shree-surya/Contactor_IQC_Esp/hmi/README.md

# Contactor IQC – HMI firmware (CrowPanel 7")

Touch-screen firmware for the **Elecrow CrowPanel 7" ESP32-S3 (DIS08070H, V3.0)**.

This first build has the **complete UI with a simulated test rig**. You can log in, pick a
model, enter 5 serials and run a full 5-channel batch on the screen before any relay,
INA219 or sub-board is wired. The header shows `SIM` while the simulation is active.

| Step | Status |
|---|---|
| UI: all screens, keyboard, 5-channel test table | ✅ this build |
| Test sequence (staggered start, stop at first fail, -NA- logging) | ✅ runs against simulated hardware |
| WiFi: up to 5 saved networks (WIFI page), retried every 15 s | ✅ this build |
| Google Sheets (specs, operators, results upload, offline queue) | ✅ needs `include/secrets.h` |
| I²C link to the ESP32-S3 sub-board | ⏳ after the parts arrive |

## Screens

| | |
|---|---|
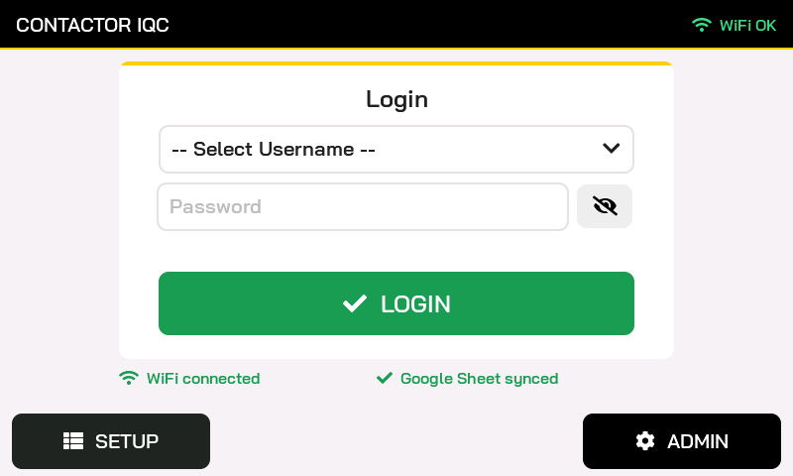
[picture p1: hmi/docs/screenshots/1_login.png]
Login
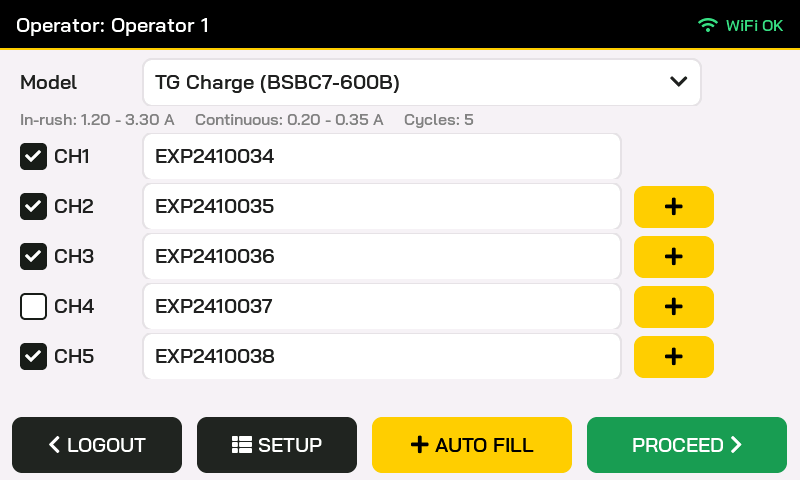
[picture p2: hmi/docs/screenshots/2_model_serials.png]
Model & serials
|  |  |
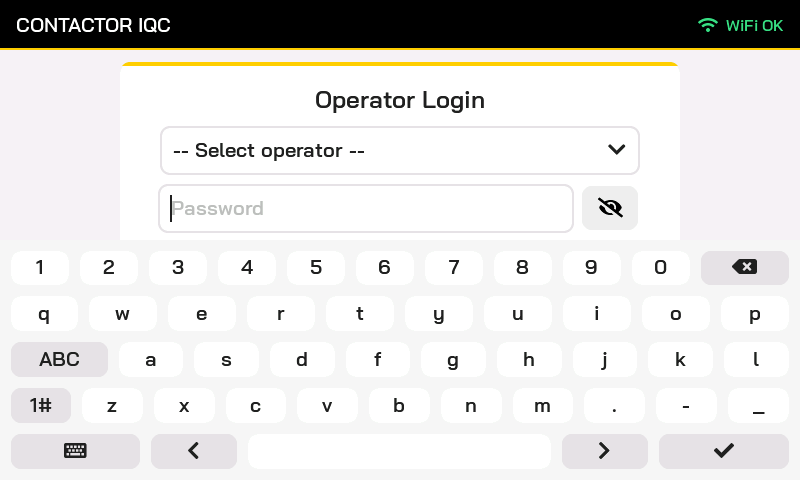
[picture p3: hmi/docs/screenshots/3_keyboard.png]
Keyboard
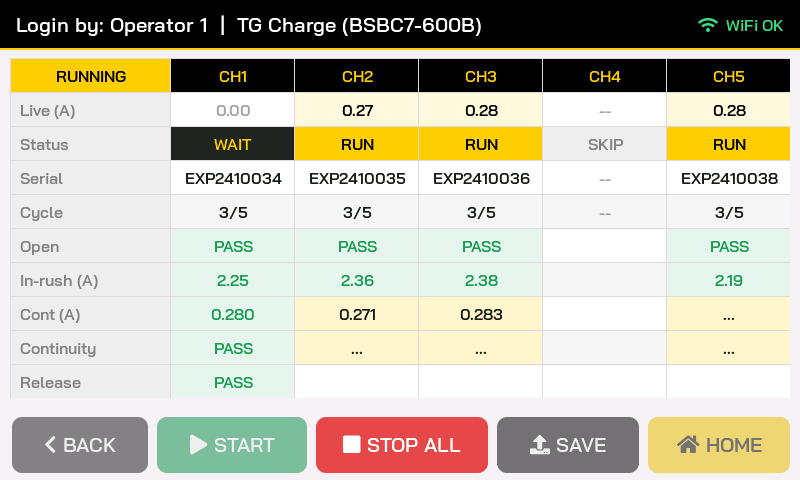
[picture p4: hmi/docs/screenshots/4_test_running.png]
Test running
|  |  |
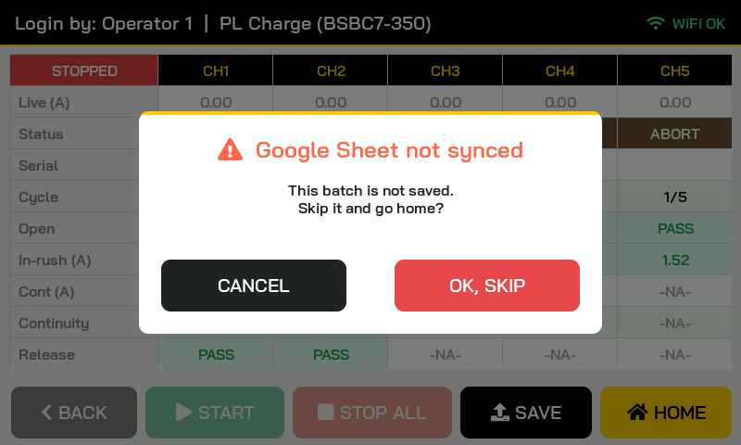
[picture p5: hmi/docs/screenshots/5_test_done_with_fail.png]
HOME without saving
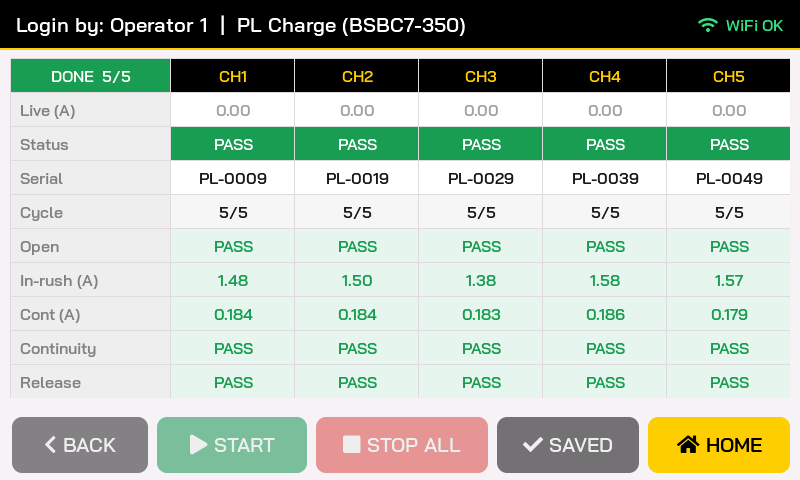
[picture p6: hmi/docs/screenshots/6_saved.png]
Saved
|  |  |
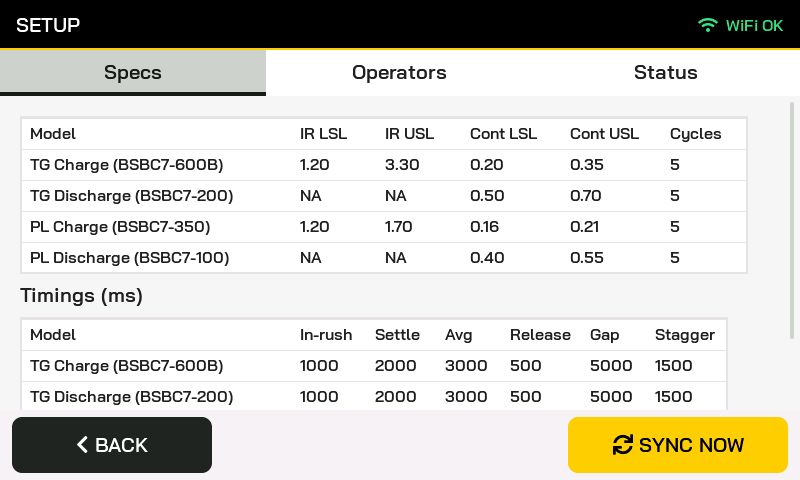
[picture p7: hmi/docs/screenshots/7_setup.png]
Setup
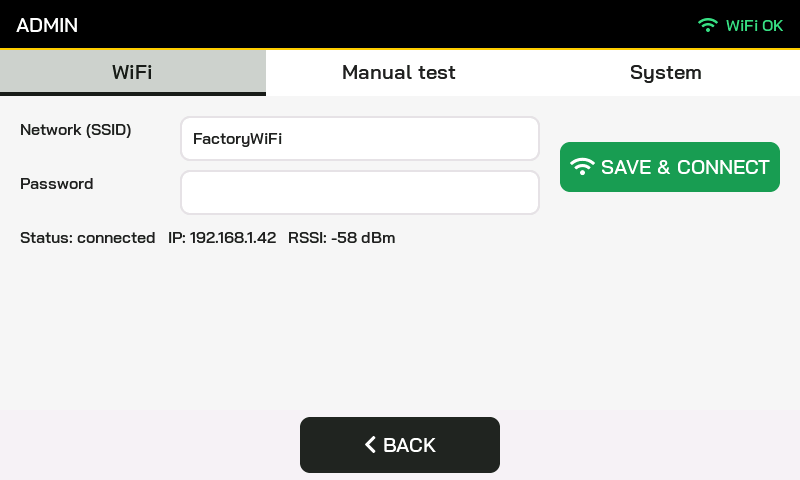
[picture p8: hmi/docs/screenshots/8_admin_wifi.png]
Admin
|  |  |

## Flashing (first time)

1. In VS Code: **File → Open Folder…** and select `hmi` (the folder that contains
   `platformio.ini`, not the repository root).
2. Wait for PlatformIO to finish "Installing…" in the bottom bar. The first time it downloads
   the ESP32 toolchain, LVGL and LovyanGFX, which takes 5–10 minutes.
3. Connect the CrowPanel to the PC with the USB-C port marked **UART0**.
4. Click **✓ Build** (bottom bar), then **→ Upload**.
   - If the upload can't find the board, uncomment `upload_port = COM11` in `platformio.ini`.
   - If it still fails, hold **BOOT**, tap **RESET**, release **BOOT**, then upload again.
     Press **RESET** after the upload finishes.
5. Click the **plug icon (Serial Monitor)** to see the log at 115200 baud. You should see
   `Contactor IQC HMI 0.1.0-ui-sim`.

## Trying it out

1. **Login:** pick *Operator 1* → LOGIN.
2. **Model:** pick a model and type a serial for CH1 with the on-screen keyboard.
   - **+** next to CH2…CH5 copies the serial above and adds 1 (`EXP2410034` → `EXP2410035`).
   - **AUTO FILL** fills every empty channel that way.
   - **COPY / PASTE / CLEAR** are on the keyboard.
   - Untick a channel to skip it.
3. **PROCEED → START.** Channels start 1.5 s apart, each runs 5 cycles, and about 2% of
   simulated cycles get a random fault, so you will see the occasional FAIL.
4. **STOP ALL** switches everything off and marks the unfinished steps `-NA-`.
5. **SAVE** (enabled when every channel has finished, or after STOP ALL) sends the batch to the
   Google Sheet. Results stay in RAM until then; nothing is uploaded during a test.
6. **HOME** goes back to the model page for the next batch. If the batch was not saved it asks
   first ("Google Sheet not synced"): **OK, SKIP** throws the results away, **CANCEL** stays on the page.
7. While a channel rests between cycles its Status shows **WAIT**, and **RUN** again when the next cycle starts.
8. **Retest:** a finished channel (PASS / FAIL / ABORT) shows ↻ on its CH header. Tap it to run that
   channel again from cycle 1; the others keep going. Only the newest result is saved. Not after SAVE.
9. **WIFI** (login screen, password `100100`): scan, connect to a network with its password, or FORGET a
   saved one. Up to 5 are saved; while WiFi is down the panel tries them every 15 s, forever.
10. **PENDING** (login screen): results saved on the panel but not in the Google Sheet yet. The badge
   shows how many; rows disappear as they upload. **UPLOAD NOW** tries straight away.
11. **ADMIN** (password `100100`): toggle relays manually, view system info.

Saved rows are uploaded straight from RAM; only if that fails are they kept in flash and retried automatically; Setup → Status shows the Sheets state. While the rig is simulated (`SIM` in the header), the uploaded rows are simulated data too.

## If something looks wrong

| Symptom | What to tell me / try |
|---|---|
| Screen stays black | Send the Serial Monitor log. The backlight pin may differ on your board revision. |
| Display works but touch doesn't | Send the log line that starts with `[display]`. |
| Touch is offset or mirrored | Tell me which corner you tap and where the press lands. |
| Picture shifts or flickers when WiFi connects | Known ESP32-S3 RGB-panel issue; I'll lower the pixel clock in `display.cpp`. |

## Code layout

```
hmi
├── platformio.ini        board, PSRAM, libraries (LVGL 8.3.11, LovyanGFX 1.1.16)
├── include/lv_conf.h     LVGL settings
└── src
    ├── main.cpp          setup()/loop()
    ├── config.h          constants: channels, password, current range, I2C pins
    ├── display.cpp       RGB panel + GT911 touch + LVGL driver
    ├── app_data.cpp      models/limits and operator list (built-in defaults for now)
    ├── rig.cpp           5-channel test sequencer (moves to the sub-board later)
    ├── hw_sim.cpp        simulated relays / INA219 / contacts
    ├── net.cpp           WiFi
    ├── gsheets.cpp       Google Sheets: login (JWT), read Specs/Operators, append Results, flash queue
    ├── google_roots.h    Google root certificates for HTTPS
    ├── serial_util.cpp   "+" serial increment
    ├── fonts/            Bai Jamjuree SemiBold 16/20/24/32 px (+ LVGL symbols), OFL licence
    └── ui/
        ├── ui_theme.h    all colours, fonts and sizes
        ├── ui_common.cpp header, footer, buttons, pop-ups
        ├── ui_login.cpp  operator login
        ├── ui_model.cpp  model + 5 serials + keyboard
        ├── ui_test.cpp   5-channel result table
        ├── ui_setup.cpp  specs / operators / status (view only)
        ├── ui_wifi.cpp   WiFi networks: scan, connect, forget
        ├── ui_pending.cpp results not in the Google Sheet yet
        └── ui_admin.cpp  password, manual relay test, system
```

To change colours or text sizes, edit `src/ui/ui_theme.h`. Light theme: black bars with yellow
`#FFCC00` accents, white/light-grey surfaces, grey text `#808080` / `#A0A0A0`, green for PASS,
red for FAIL. Font: Bai Jamjuree SemiBold.

Fonts were generated with `lv_font_conv` (4 bpp, ASCII + LVGL symbols). To add a size, run e.g.:
`npx lv_font_conv --bpp 4 --size 28 --no-compress --font BaiJamjuree-SemiBold.ttf --range 0x20-0x7E --font FontAwesome5-Solid+Brands+Regular.woff --range <symbol list from font_bai_16.c header> --format lvgl --lv-include lvgl.h -o font_bai_28.c`
