shree-surya/Contactor_IQC_Esp/docs/GOOGLE_SHEETS_SETUP.md

# Google Sheets setup

The rig reads **Specs** and **Operators** from a Google Sheet and appends test results to its
**Results** tab. It signs in with a Google Cloud **service account** (JSON key), so no Apps
Script is needed.

Allow about 30 minutes. You only do this once.

---

## Part A: Create the Sheet from the template

1. Download [`Contactor_IQC_Sheet_Template.xlsx`](Contactor_IQC_Sheet_Template.xlsx) from this folder.
2. Open **drive.google.com**, then **New → File upload**, and pick the template.
3. Double-click the uploaded file. It opens in Google Sheets.
4. **File → Save as Google Sheets.** This step is required: the API can't write to an `.xlsx`.
   A new copy opens.
5. Rename that copy to **Contactor IQC** (top-left title) and delete the uploaded `.xlsx` from Drive.
6. Check it has 4 tabs: **Specs, Operators, Results, README**.
   - **Specs:** check the 4 models and their limits.
   - **Operators:** column A = name, column B = login password (max 10 rows; empty password = none).
   - Don't rename tabs or edit header rows.
7. Copy the **Sheet ID** from the address bar and keep it for Part D:

   ```
   https://docs.google.com/spreadsheets/d/1AbCdEfGhIjKlMnOpQrStUvWxYz0123456789/edit#gid=0
                                          └──────────── this is the Sheet ID ───────┘
   ```

---

## Part B: Create the service account (Google Cloud)

1. Open **console.cloud.google.com** and sign in with the same Google account.
2. Top bar → project picker → **New Project**. Name it `Contactor-IQC` → **Create**, then select it.
3. **☰ Menu → APIs & Services → Library**. Search **Google Sheets API** → open it → **Enable**.
4. **☰ Menu → IAM & Admin → Service Accounts → + Create service account**.
   - Name: `iqc-rig` → **Create and continue**.
   - Roles: leave empty → **Continue** → **Done**.
5. Click the new account (`iqc-rig@contactor-iqc-xxxx.iam.gserviceaccount.com`) → **Keys** tab →
   **Add key → Create new key → JSON → Create**. A `.json` file downloads.
   - If you see *"Service account key creation is disabled"*, your company blocks keys by policy.
     Ask IT to allow it for this project (policy `iam.disableServiceAccountKeyCreation`).
6. **Keep this JSON file private.** Don't email it, upload it to GitHub, or send it in chat. Anyone
   with it can edit the Sheet.

---

## Part C: Share the Sheet with the service account

1. Open the JSON file in Notepad and copy the `client_email` value
   (ends in `.iam.gserviceaccount.com`).
2. In the **Contactor IQC** Sheet: **Share** → paste that email → role **Editor** →
   untick *Notify people* → **Share**.

---

## Part D: Put the key into the firmware

1. In `hmi/include/`, copy `secrets.example.h` and name the copy **`secrets.h`**.
   `secrets.h` is listed in `.gitignore`, so it never goes to GitHub.
2. Fill it from the JSON file and the Sheet ID:

   | `secrets.h` | Where it comes from |
   |---|---|
   | `GSHEET_ID` | Part A step 7 |
   | `GSA_PROJECT_ID` | JSON `project_id` |
   | `GSA_CLIENT_EMAIL` | JSON `client_email` |
   | `GSA_PRIVATE_KEY` | JSON `private_key`: copy everything between the quotes, **including** the `\n` sequences, exactly as it is |

3. Save. Don't commit. Run `git status` and check that `secrets.h` is **not** listed.

---

## Part E: Network check

From a laptop on the **same WiFi** the rig will use, open these in a browser:

- `https://oauth2.googleapis.com`
- `https://sheets.googleapis.com`

Any response (even "404" or "Not Found") means the network allows it. "Blocked", a login page,
or a timeout means IT has to allow those two hosts.

---

## When you're done

Tell me **"Sheets setup done"**. Don't send the key or the JSON. I'll then add the Sheets code to
the firmware:

- download Specs + Operators at boot and on **SYNC NOW**, and cache them in flash for offline use
- append one Results row per channel per cycle
- queue rows in flash while WiFi is down and upload them later
- timestamp from Google's clock, `*` when the rig was offline

---

## Results layout (one row per contactor)

Each tested contactor is **one row**:

`S.No | Serial | Timestamp | Operator | Model | Channel | Overall | Fail Step | 1- Contin. OFF | 1- Inrush (A) | 1- Inrush P/F | 1- Cont (A) | 1- Cont P/F | 1- Contin. ON | 1- Release | 2- Contin. OFF | … | 5- Release`

- **Overall** is PASS (all cycles passed), FAIL, or ABORTED (STOP ALL).
- Up to 5 cycles per unit (the **Cycles** column in Specs can be 1 to 5).
- Cycles that were not run (after a failure, or a model with fewer than 5 cycles) show `-NA-` or stay empty.
- **Contin. OFF** is the main-terminal state before the coil is switched on: `OPEN` = pass, `CLOSE` = FAIL
  (welded or stuck). `OPEN` with Fail Step "Contin OFF: current" means coil current flowed with the relay off.
- **Contin. ON** is the main-terminal state while the coil is on: `CLOSE` = pass, `OPEN` = FAIL.
- The **Timestamp** is when the unit finished (IST), written as text. A `*` at the end means the rig was
  offline when the unit finished, and the time shown is when the row was uploaded.

### Updating a Sheet you already made

If your **Results** header still says `1- Open` / `1- Continuity`, rename them to `1- Contin. OFF` /
`1- Contin. ON` (same for cycles 2 to 5), or paste the header from `docs/results_header.tsv`.

If your **Results** tab still has an older header (one row per cycle, or columns up to `10- Release`):

1. Delete all rows in **Results**, including the header.
2. Open [`results_header.tsv`](results_header.tsv), select all, copy.
3. Click cell **A1** of **Results**, then paste. The 43 headers fill row 1 (A to AQ). Delete any columns to the right of AQ.
4. (Optional) Make row 1 bold and use **View → Freeze → 1 row**.

Also check **Operators** has the password in column B.
