shree-surya/Contactor_IQC_Esp/(commit log)

2026-10-07 Add CrowPanel 7" HMI firmware with simulated 5-channel rig
    Touch UI (LVGL 8.3 + LovyanGFX) for the CrowPanel DIS08070H V3.0:
    operator login, model + 5 serials with increment/copy/paste, 5-channel
    result table, setup view, admin (WiFi, manual relay test, system).
    Includes the 5-channel test sequencer running on simulated hardware
    until the ESP32-S3 sub-board is built.
    Claude-Session: https://claude.ai/code/session_01LXTvxhwrQucbbkRLzNXi3e
2026-10-07 Fix build: use I2C port number instead of I2C_NUM_1
    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
    [display.cpp]
2026-10-07 Dark theme with Bai Jamjuree, live current row, Google Sheets template
    - Near-black base with cyan/orange/lime accents (red reserved for FAIL)
    - Bai Jamjuree SemiBold fonts (16/20/24/32 px) with LVGL symbols merged
    - Test screen: per-channel live current row, batch state in the table
    corner; removed round/live line and bottom event line
    - docs/: Google Sheet template (Specs, Operators, Results, README) and
    step-by-step service-account setup guide
    - hmi/include/secrets.example.h for the service-account key
    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
    [Contactor_IQC_Sheet_Template.xlsx]
2026-10-07 Light theme, Live row on top, Google Sheets link with offline queue
    - Light theme from the reference design: black bars, #FFCC00 accent,
    grey secondary text, green PASS / red FAIL, Bai Jamjuree
    - Test table order: Live (A), Status, Serial, Cycle, then the steps
    - NEXT BATCH clears the model so it is chosen again for every batch
    - gsheets: service-account login (RS256 JWT via mbedTLS), reads Specs and
    Operators at boot / SYNC NOW, caches them in LittleFS, appends Results
    rows from a flash queue in a background task, clock from NTP with an
    HTTP Date fallback, rows logged offline get the upload time plus '*'
    - Setup > Status shows Sheets state, last sync, rows to upload, clock
    Co-Autho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
    [app_data.cpp, app_data.h, config.h, google_roots.h, gsheets.cpp, gsheets.h, main.cpp]
2026-10-07 Operator passwords from the Sheet, factory WiFi via secrets.h
    - Login screen: password field with keyboard; checked against column B of
    the Operators tab (last synced copy, so it also works offline);
    empty password in the Sheet = no password
    - Sheets sync reads Operators!A2:B11 and caches the passwords
    - secrets.h can define WIFI_SSID / WIFI_PASS, used until other
    credentials are saved on the Admin screen
    - Template and setup guide updated with the password column
    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
    [Contactor_IQC_Sheet_Template.xlsx]
2026-10-07 Login status and sync gate, eye icon, number-row keyboard, one Results row per unit
    - Login: WiFi and Google Sheet status line; operator selection unlocks
    once the Sheet has synced (or after 30 s offline with a saved copy)
    - Password field: show/hide eye button; text keyboards get a number row
    - Top bar: colour-coded WiFi indicator on every screen (green connected,
    blinking yellow connecting, grey none); upload count and SIM removed
    - NEXT BATCH: popup waits for the Sheet upload, shows success (or saved
    offline), then returns to the model / serial page
    - Results: one row per contactor - S.No, Serial, Timestamp, Operator,
    Model, Channel, Overall, Fail Step, then 7 columns per cycle (u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
    [Contactor_IQC_Sheet_Template.xlsx, results_header.tsv]
2026-10-07 Fix README screenshot links, version 0.3.0
    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
    [config.h]
2026-10-08 Fix test-screen flicker, pause Sheet uploads during tests, 5-cycle Results
    - Test grid uses one object per cell instead of lv_table, so a value change
    redraws only that cell (~40x less frame-buffer traffic while running)
    - Sheet uploads and syncs wait while a test runs; NEXT BATCH uploads them
    - MAX_CYCLES 5: Results template and header TSV now end at 5- Release (43 cols)
    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
    [Contactor_IQC_Sheet_Template.xlsx, results_header.tsv]
2026-10-09 SAVE button, HOME replaces NEXT BATCH, WAIT status between cycles, login wording
    - Finished units stay in RAM during a test; SAVE (enabled when all channels
    are done or after STOP ALL) queues and uploads them. Writing flash while
    the RGB panel draws caused the glitch seen after the first unit finished.
    - HOME goes to the model page; unsaved results need a DON'T SAVE confirmation
    - Channel status shows WAIT while resting between cycles
    - Login: 'Login', 'Select Username'; header 'Login by: name'
    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
    [config.h, gsheets.cpp, main.cpp, rig.cpp, rig.h]
2026-10-09 HOME interlock popup: 'Google Sheet not synced' with CANCEL / OK, SKIP
    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
    [config.h]
2026-10-09 Fix SAVE glitch: upload from RAM, flash only when offline; static save popup
    - SAVE no longer writes rows to flash; they are uploaded straight from RAM.
    Only if the upload can't happen (no WiFi, error, 20 s) are they persisted.
    Flash writes and the queue rewrite stalled the PSRAM bus feeding the panel.
    - Save popup has no spinner (constant frame-buffer redraws during TLS)
    - Each row's timestamp is taken when the unit finishes, not at SAVE
    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
    [config.h, gsheets.cpp, gsheets.h, rig.cpp, rig.h]
2026-10-09 Keep WiFi/TLS buffers in internal RAM; pixel clock in config.h
    The RGB panel reads its frame buffer from PSRAM continuously; uploads with
    their buffers in PSRAM compete for the same bus. Allocations up to 64 KB now
    prefer internal RAM (automatic fallback to PSRAM). PANEL_PCLK_HZ in config.h
    makes the display clock easy to lower if glitches remain.
    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
    [config.h, display.cpp, main.cpp]
2026-10-09 Power-cut safe flash files: cache written via temp file, interrupted swaps recovered at boot
    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
    [config.h, gsheets.cpp]
2026-10-15 rig: INA219 bring-up firmware for the ESP32-S3 sub-board
    Reads 5 INA219s (4 on I2C0 at 0x40/41/44/45, 1 on I2C1) and prints current
    and bus voltage; serial commands for bus scan and a 1 s fast peak test
    (shunt-only 9-bit, ~84 us per sample). Wiring guide in rig/README.md.
    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
2026-10-15 rig: all 5 INA219 on I2C0 (CH5 at 0x42 via A0=SDA), I2C1 reserved for the HMI link
    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
2026-10-23 rig: optional bench setup with CH5 on bus B (no address wire needed)
    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
2026-10-27 rig: 20 ms I2C timeout so a stuck bus doesn't freeze the scan for minutes
    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
2026-10-27 rig: single-file Arduino IDE version of the INA219 test
    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
2026-10-27 rig: use the USB Native port (UART port holds the 7Semi board in reset with a monitor open)
    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
2026-10-27 rig: single-sensor capture sketch (auto-detect, auto-trigger, in-rush + continuous report)
    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
2026-10-27 rig capture: hardware-averaged hold current (PWM economizer coils), supply voltage, ignore after power-off
    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
2026-10-27 rig: 5-sensor capture sketch (in-rush + averaged hold per channel, cross-channel deviation)
    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
2026-10-27 rig: relay board test sketch
    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
2026-10-28 Connect the HMI to the real rig board over I2C
    Rig board (rig/arduino/rig_firmware): samples 5 INA219s (peak + average since
    reset), drives 5 relays, I2C slave 0x30 on GPIO 17/18, relays off if the HMI
    goes silent for 1.5 s.
    HMI 0.4.0: hw.h interface with hw_link.cpp (real board, RIG_LINK 1, uses the
    touch controller's I2C port through LovyanGFX) and hw_sim.cpp (RIG_LINK 0).
    Sequencer uses the board's in-rush peak and window average (correct for PWM
    economizer coils); without contact inputs Open/Release use current only and
    Continuity is -NA-. START checks the rig board and every ticked sensor; a lost
    link stops the test.
    Claude-Sessi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
2026-10-28 capture5: all 5 sensors on GPIO 8/9, CH5 at 0x42, bus scan at start
    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
2026-10-28 rig: relay + 5-sensor bench sketch (toggle relays, live current/voltage, in-rush/hold per switch-on)
    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
2026-10-28 Rig link diagnostics: rig board prints relay changes and command/read counts; HMI shows relay command errors (0.4.1)
    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
2026-10-28 Continuity check for 4-pin contactors, chosen per model from the Specs sheet (0.5.0)
    - Specs tab: new column M "Continuity" (Yes / No). Yes = feedback contact
    is checked and the HMI shows CLOSE / OPEN; No (2-pin) shows -NA-.
    - Rig board firmware: reads feedback contacts on GPIO 1, 2, 10, 11, 12
    (contact to GND, internal pull-up), 5 ms debounce, latches any opening
    since the last stats reset; status packet version 2 carries both flags.
    - HMI: accepts packet version 1 or 2, uses the contacts only for models with
    Continuity = Yes, refuses START if such a model is selected and the rig
    firmware has no contact inputs. Setup > Specs shows the Continuity column.
    - Template xlsx and setup d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
2026-10-29 Continuity on every contactor: main terminals OPEN before ON, CLOSE while ON
    - Removes the per-model Specs "Continuity" column: every contactor is tested.
    - Contin. OFF (was Open): main terminals must be OPEN and coil current ~0
    before the relay switches on. Contin. ON (was Continuity): terminals must
    stay CLOSE for the whole averaging window. Release check kept.
    - Test screen and Results show the terminal state (OPEN / CLOSE), green when
    expected, red when not. Fail steps: "Contin OFF: CLOSE", "Contin OFF:
    current", "Contin ON: OPEN", "Release: CLOSE", "Release: current".
    - START is refused if the rig board firmware cannot read continuity.
    - Results header, template xlsx and docs re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
2026-10-29 Continuity wiring: GPIO straight to terminal A, B to GND (internal pull-up); 2.2k only if noisy
    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
2026-11-03 Relays OFF at power-up, WiFi auto-retry + WiFi page, Pending Uploads page, channel retest (0.6.0)
    - Rig board: relay pins are latched HIGH (OFF) in the GPIO register before
    becoming outputs. digitalWrite() before pinMode() is ignored on ESP32
    core 3.x, so the pins came up LOW = all relays ON. The HMI also sends its
    relay state (all OFF after boot) whenever the link (re)connects.
    - WiFi: up to 5 saved networks in NVS (old single network and secrets.h
    default migrated). net_tick() retries every 15 s forever while WiFi is
    down, trying the saved networks strongest first; modem sleep off. Before,
    a failed first connect was never retried until reboot.
    - WIFI page (login screen, admin p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
2026-11-03 Rig board: CH3 continuity moved from GPIO 10 to GPIO 13
    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
